sedorrr/c64-audio-receiver/case/preview_receiver_section.png

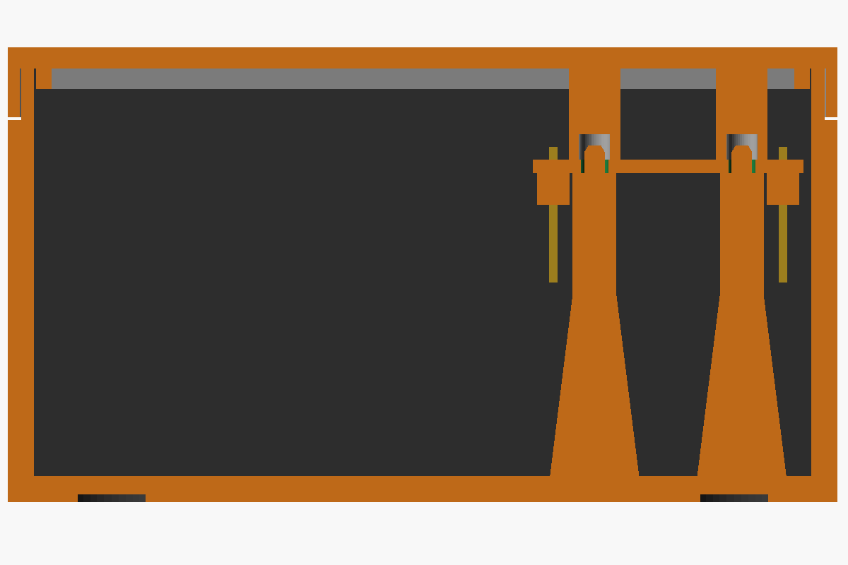
case/preview_receiver_section.png
