sedorrr/c64-audio-receiver/case/preview_receiver_section_jack.png

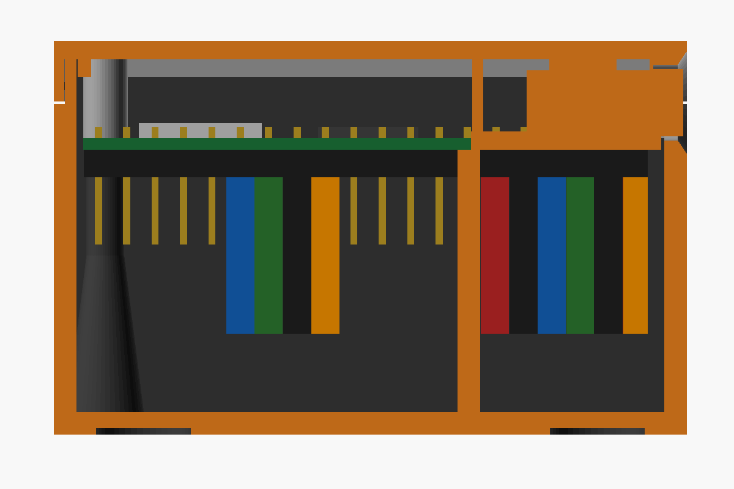
case/preview_receiver_section_jack.png
