sedorrr/c64-audio-receiver/docs/schematic_de.png

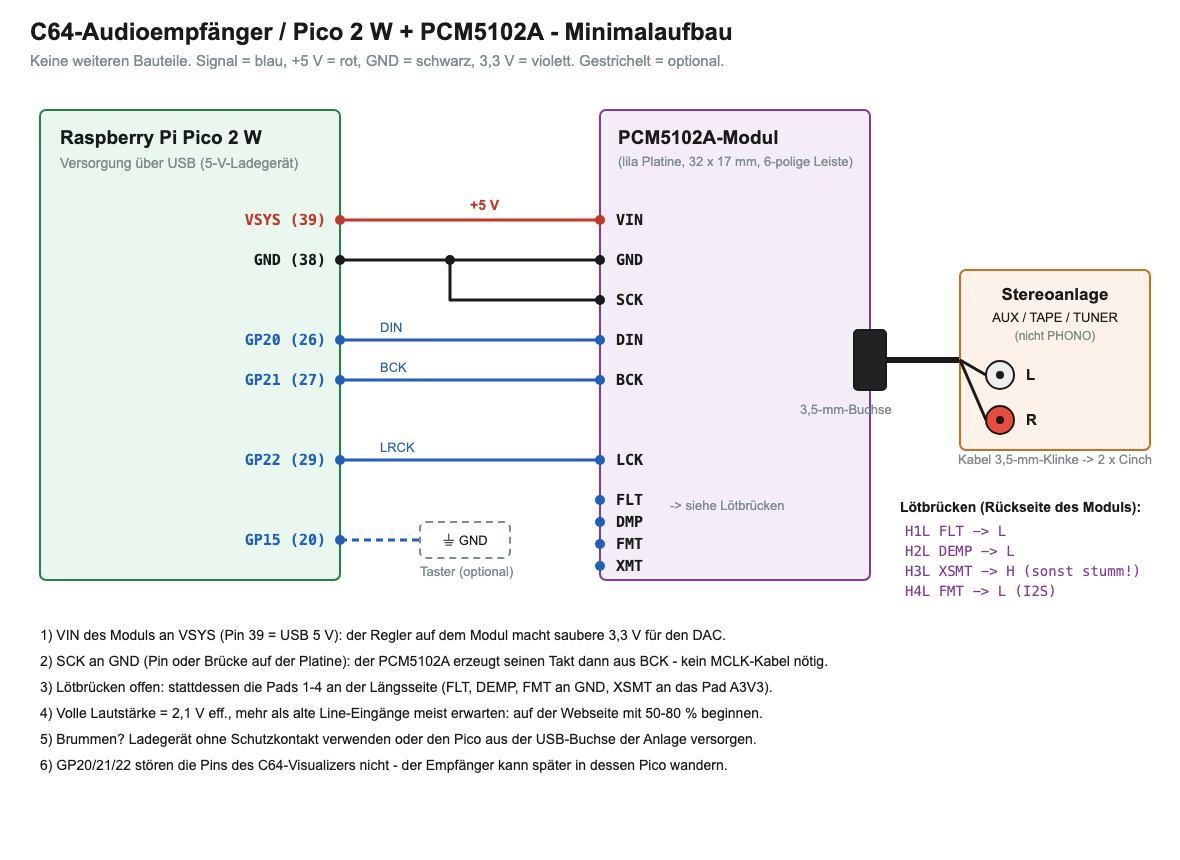
docs/schematic_de.png
