sedorrr/c64-audio-receiver/case/step/assembly_receiver_case.step

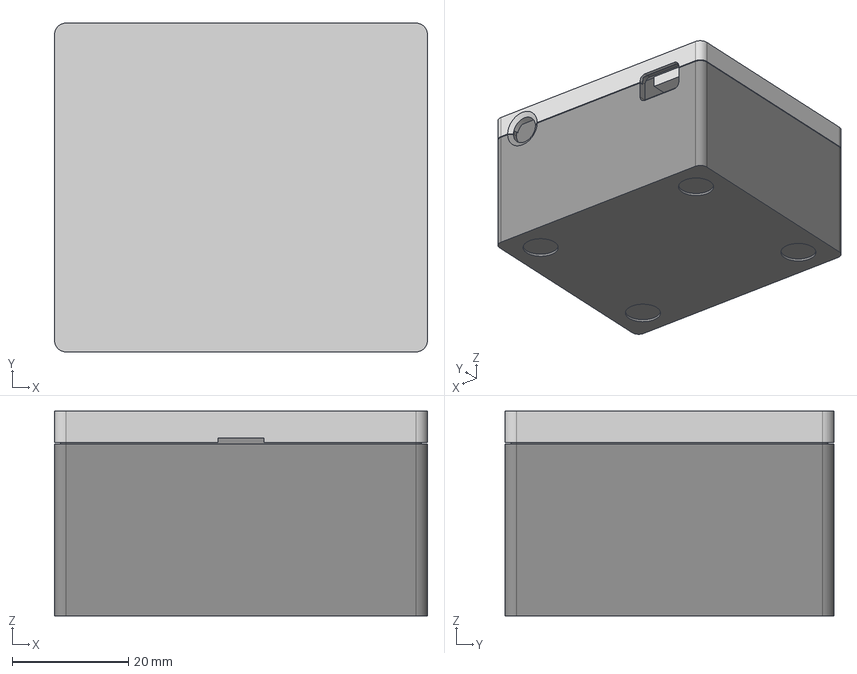
[picture p10: CAD file, 2026-10-26]
case/step/assembly_receiver_case.step
64.2 x 56.6 x 35.2 mm
receiver_base
receiver_lid
pico2w_reference
pcm5102a_reference
jack_reference
