sedorrr/c64-audio-receiver/case/step/receiver_lid.step

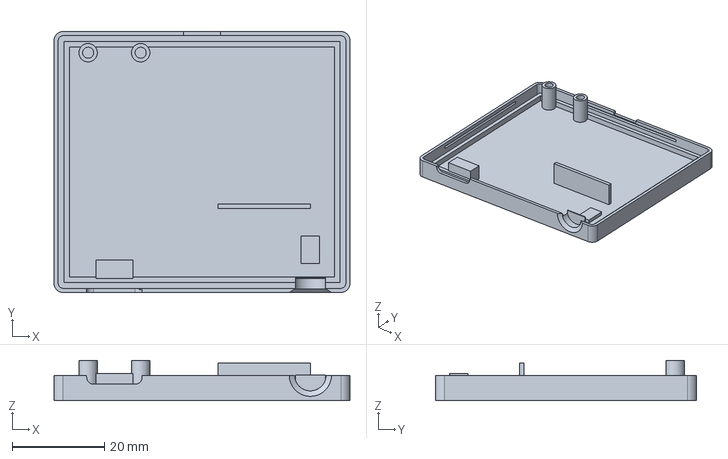
[picture p11: CAD file, 2026-10-26]
case/step/receiver_lid.step
64.2 x 56.6 x 8.70 mm
