sedorrr/c64-audio-receiver/case/step/receiver_base.step

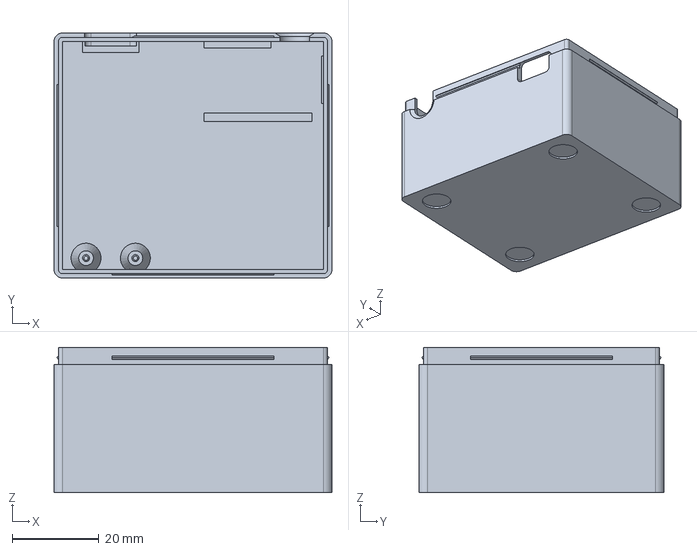
[picture p12: CAD file, 2026-10-26]
case/step/receiver_base.step
64.2 x 56.6 x 33.6 mm
