sedorrr/c64-audio-receiver/(list of files, cad)

Other CAD files:
case/receiver_base.stl
case/receiver_lid.stl
