sedorrr/c64-audio-receiver/(commit log)

2026-10-26 C64-Ökosystem: C64 audio receiver: Pico 2 W + PCM5102A plays the Ultimate 64 audio stream on a stereo and passes it on (Stand 2026-10-26)
    [assembly_receiver_case.step, receiver_base.step, receiver_base.stl, receiver_case.scad, receiver_lid.step, receiver_lid.stl]
2026-10-26 README: Stand der Prüfungen am echten Gerät (PCM5102A, Klang an der Stereoanlage)
